atx/minilocker/README.md

# minilocker
Mini PCIe board with an accelerometer, gyroscope and magnetometer. Designed to protect againts the "Silk Road attack"
