atx/minilocker/pcb/pcb.kicad_pcb

## KiCad design pcb/pcb.kicad_pcb (2016-07-05)

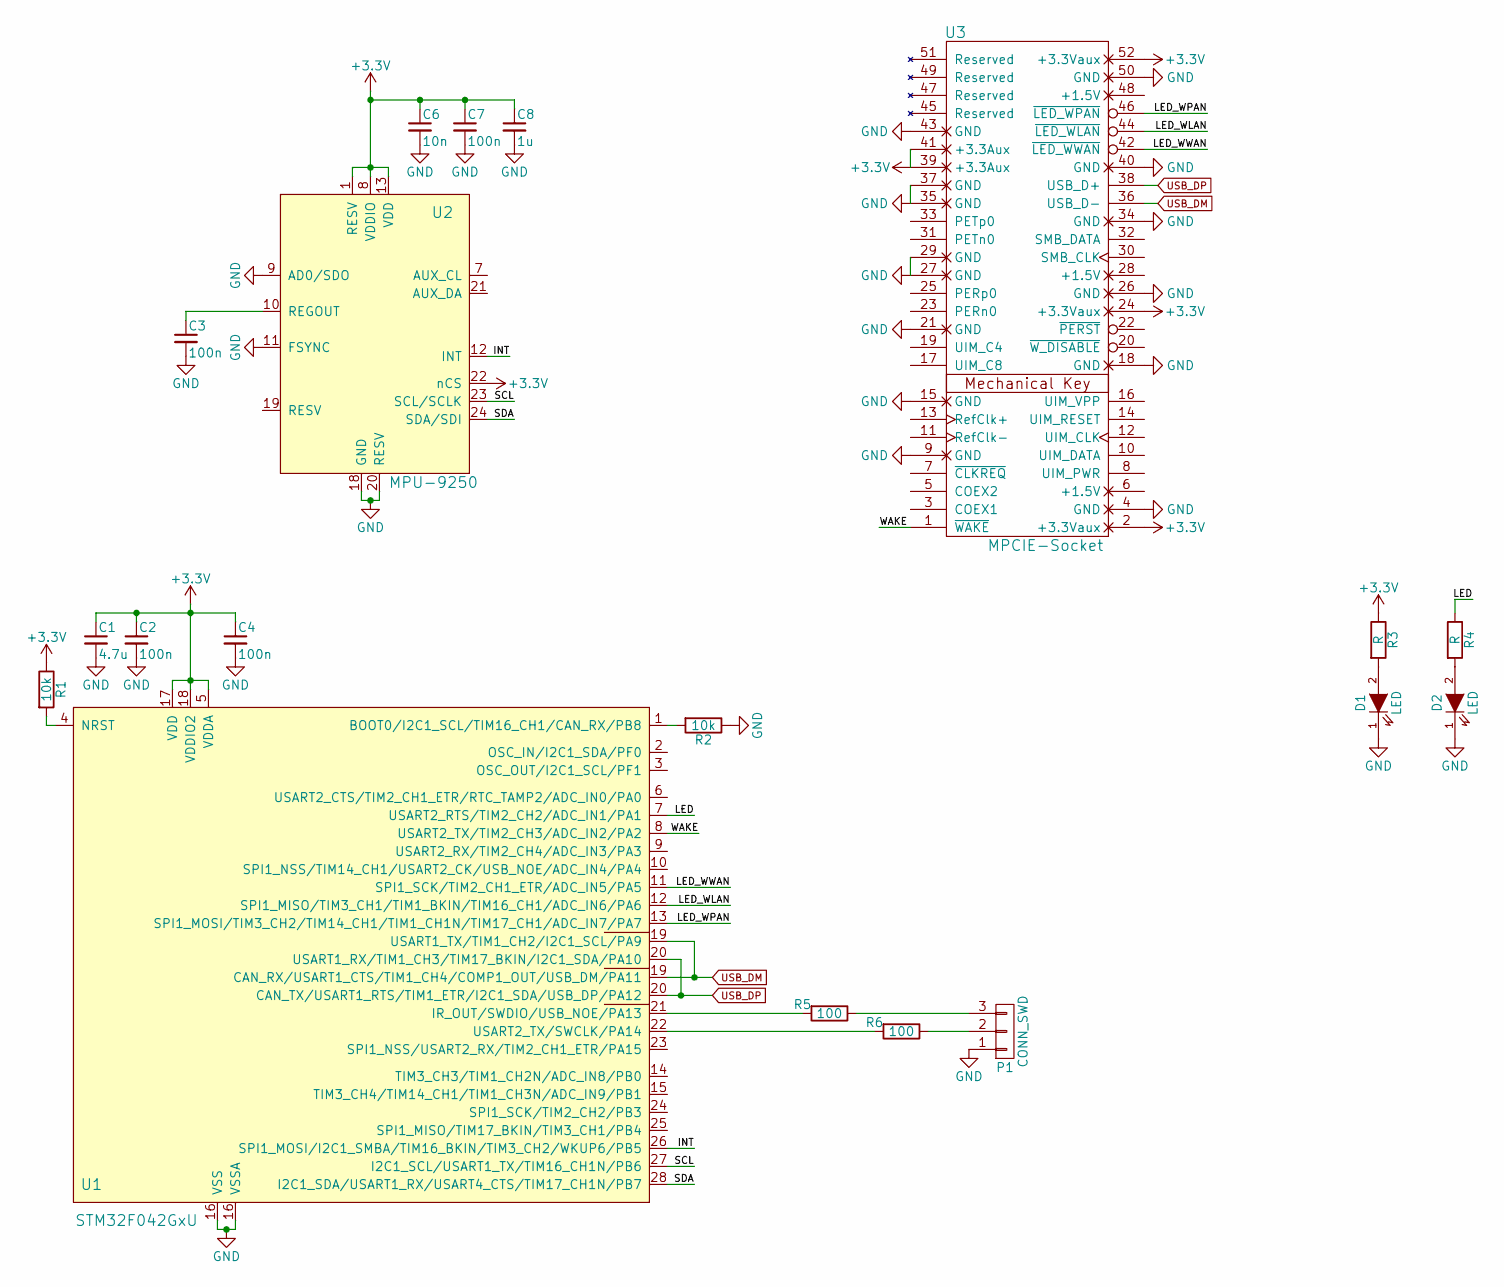
[picture p1: schematic pcb.sch]

Parts:
C1: 4.7u; R_0603
C2, C3, C4, C7: 100n; R_0402
C6: 10n; R_0402
C8: 1u; R_0402
D1, D2: LED; R_0603
P1: CONN_SWD; Pin_Header_Angled_1x03
R1, R2: 10k; R_0402
R3, R4: R; R_0402
R5, R6: 100; R_0402
U1: STM32F042GxU; UFQFPN28
U2: MPU-9250; QFN-24-1EP_3x3mm_Pitch0.4mm
U3: MPCIE-Socket; mpcie-half-card

Connections:
+3V3: C1.1, C2.1, C4.1, C6.1, C7.1, C8.1, R1.1, R3.1, U1.5 (VDDA), U1.17 (VDD), U1.18 (VDDIO2), U2.1 (RESV), U2.8 (VDDIO), U2.13 (VDD), U2.22 (nCS), U3.2 (+3.3Vaux), U3.24 (+3.3Vaux), U3.39 (+3.3Aux), U3.41 (+3.3Aux), U3.52 (+3.3Vaux)
/INT: U1.26 (SPI1_MOSI/I2C1_SMBA/TIM16_BKIN/TIM3_CH2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), U2.12 (INT)
/LED: R4.1, U1.7 (USART2_RTS/TIM2_CH2/ADC_IN1/PA1)
/LED_WLAN: U1.12 (SPI1_MISO/TIM3_CH1/TIM1_BKIN/TIM16_CH1/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), U3.44 (~LED_WLAN)
/LED_WPAN: U1.13 (SPI1_MOSI/TIM3_CH2/TIM14_CH1/TIM1_CH1N/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), U3.46 (~LED_WPAN)
/LED_WWAN: U1.11 (SPI1_SCK/TIM2_CH1_ETR/ADC_IN5/PA5), U3.42 (~LED_WWAN)
/SCL: U1.27 (I2C1_SCL/USART1_TX/TIM16_CH1N/PB6), U2.23 (SCL/SCLK)
/SDA: U1.28 (I2C1_SDA/USART1_RX/USART4_CTS/TIM17_CH1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), U2.24 (SDA/SDI)
/WAKE: U1.8 (USART2_TX/TIM2_CH3/ADC_IN2/PA2), U3.1 (~WAKE)
GND: C1.2, C2.2, C3.2, C4.2, C6.2, C7.2, C8.2, D1.1 (K), D2.1 (K), P1.1, R2.1, U1.16 (VSS), U2.9 (AD0/SDO), U2.11 (FSYNC), U2.18 (GND), U2.20 (RESV), U3.4 (GND), U3.9 (GND), U3.15 (GND), U3.18 (GND), U3.21 (GND), U3.26 (GND), U3.27 (GND), U3.29 (GND), U3.34 (GND), U3.35 (GND), U3.37 (GND), U3.40 (GND), U3.43 (GND), U3.50 (GND)
unnamed: C3.1, U2.10 (REGOUT)
unnamed: D1.2 (A), R3.2
unnamed: D2.2 (A), R4.2
unnamed: P1.2, R6.1
unnamed: P1.3, R5.1
unnamed: R1.2, U1.4 (NRST)
unnamed: R2.2, U1.1 (BOOT0/I2C1_SCL/TIM16_CH1/CAN_RX/PB8)
unnamed: R5.2, U1.21 (IR_OUT/SWDIO/USB_NOE/PA13)
unnamed: R6.2, U1.22 (USART2_TX/SWCLK/PA14)
USB_DM: U1.19 (CAN_RX/USART1_CTS/TIM1_CH4/COMP1_OUT/US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), U3.36 (USB_D-)
USB_DP: U1.20 (CAN_TX/USART1_RTS/TIM1_ETR/I2C1_SDA/USB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), U3.38 (USB_D+)

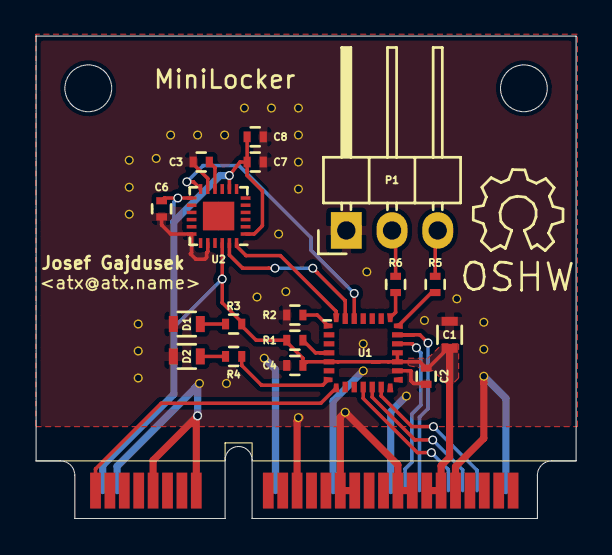
[picture p2: board pcb.kicad_pcb from above]

Board: 2 copper layers, 30.0 x 26.8 mm, 19 parts (0 on the bottom side), 21 nets.
