atx/minilocker/src/comm.c

/* 
 * Copyright (C) 2016 Institute of Applied and Experimental Physics (http://www.utef.cvut.cz/)
 *
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
 * You should have received a copy of the GNU Lesser General Public License
 * along with this program.  If not, see <http://www.gnu.org/licenses/>.*
 */

#include <limits.h>
#include <stdbool.h>
#include <stddef.h>
#include <stdint.h>
#include <string.h>

#include "acq.h"
#include "cdc.h"
#include "comm.h"
#include "utils.h"

#define FIRMWARE_VERSION	1

enum packet_type {
	/* Host -> Device */
	PACKET_NOP		= 0x01,
	PACKET_PING		= 0x02,
	PACKET_GET		= 0x03,
	PACKET_SET		= 0x04,
	PACKET_START	= 0x05,
	PACKET_STOP		= 0x06,

	/* Device -> Host */
	PACKET_PONG		= 0x82,
	PACKET_GETRESP	= 0x83,
	PACKET_IMU		= 0x84,
	PACKET_MAGNET	= 0x85,
	PACKET_ERROR    = 0xff,
};

enum error {
	EUNKNOWN	= 1,
	EINKEY		= 2,
	EINOP		= 3,
};

uint32_t comm_missed = 0;

static inline void comm_send(char *buf, size_t len, bool flush)
{
	if (!cdc_send(buf, len))
		comm_missed++;
	else if (flush)
		cdc_flush();
}

static inline void comm_send_error(enum error errno)
{
	char p[] = { PACKET_ERROR, errno };
	comm_send(p, sizeof(p), true);
}

void comm_send_imu(int16_t ax, int16_t ay, int16_t az, int16_t gx, int16_t gy, int16_t gz)
{
	char p[] = { PACKET_IMU,
				 LOBYTE(ax), HIBYTE(ax),
				 LOBYTE(ay), HIBYTE(ay),
				 LOBYTE(az), HIBYTE(az),
				 LOBYTE(gx), HIBYTE(gx),
				 LOBYTE(gy), HIBYTE(gy),
				 LOBYTE(gz), HIBYTE(gz)};
	comm_send(p, sizeof(p), false);
}

void comm_send_magnetometer(int16_t x, int16_t y, int16_t z)
{
	char p[] = { PACKET_MAGNET,
				 LOBYTE(x), HIBYTE(x),
				 LOBYTE(y), HIBYTE(y),
				 LOBYTE(z), HIBYTE(z)};
	comm_send(p, sizeof(p), false);
}

/* Handlers return the amount of bytes taken or negative value in case of failure
 * */
static int comm_cb_nop(char *buf, int len)
{
	(void)buf;
	(void)len;
	/* We do nothing, surprise! */
	return 1;
}

static int comm_cb_ping(char *buf, int len)
{
	(void)buf;
	(void)len;
	char p[] = { PACKET_PONG };
	comm_send(p, sizeof(p), true);
	return 1;
}

enum propkey {
	CONF_FW		= 0x01,
	CONF_SERNO	= 0x02,
	CONF_MAGCALX	= 0x03,
	CONF_MAGCALY	= 0x04,
	CONF_MAGCALZ	= 0x05,
};

struct propvar {
	enum propkey key;
	void (*get)(const struct propvar *prop);
	void (*set)(const struct propvar *prop, char *buf, int len);
	int len;
	void *data;
};

static void comm_const_uint16_get(const struct propvar *prop)
{
	uint16_t data = ((uint32_t) prop->data) & 0xffff;
	char p[] =
		{ PACKET_GETRESP, prop->key, LOBYTE(data), HIBYTE(data)};
	comm_send(p, sizeof(p), true);
}

static void comm_uint8_get(const struct propvar *prop)
{
	uint8_t *i = prop->data;
	char p[] =
		{ PACKET_GETRESP, prop->key, *i };
	comm_send(p, sizeof(p), true);
}

//struct boolprop {
//	void (*enable)();
//	void (*disable)();
//	bool (*isenabled)();
//};
//
//static void comm_boolprop_get(const struct propvar *prop)
//{
//	struct boolprop *bl = prop->data;
//	char p[] =
//		{ PACKET_GETRESP, prop->key,
//			bl->isenabled() ? 0x01 : 0x00 };
//
//	comm_send(p, sizeof(p), true);
//}
//
//static void comm_boolprop_set(const struct propvar *prop, char *buf, int len)
//{
//	UNUSED(prop);
//	UNUSED(len);
//
//	struct boolprop *bl = prop->data;
//
//	if (buf[2] & 0x01)
//		bl->enable();
//	else
//		bl->disable();
//}

static const struct propvar propvars[] = {
	{ CONF_FW, comm_const_uint16_get, NULL, 2, (void *)FIRMWARE_VERSION },
	{ CONF_SERNO, comm_const_uint16_get, NULL, 2, (void *)SERNO },
	{ CONF_MAGCALX, comm_uint8_get, NULL, 2, &acq_ak8963.cal_x },
	{ CONF_MAGCALY, comm_uint8_get, NULL, 2, &acq_ak8963.cal_y },
	{ CONF_MAGCALZ, comm_uint8_get, NULL, 2, &acq_ak8963.cal_z },
};

static const struct propvar *comm_resolve_key(enum propkey k)
{
	unsigned int i;

	for (i = 0; i < ARRAY_SIZE(propvars); i++)
		if (propvars[i].key == k)
			return &propvars[i];

	return NULL;
}

static int comm_cb_get(char *buf, int len)
{
	const struct propvar *p;

	if (len < 2)
		return 0;

	p = comm_resolve_key(buf[1]);

	if (p == NULL)
		comm_send_error(EINKEY);
	else if (p->get == NULL)
		comm_send_error(EINOP);
	else
		p->get(p);

	return 2;
}

static int comm_cb_set(char *buf, int len)
{
	const struct propvar *p;

	if (len < 2)
		return 0;

	p = comm_resolve_key(buf[1]);

	if (p == NULL)
		comm_send_error(EINKEY);
	else if (p->set == NULL)
		// TODO: Note that this will probably produce some garbage bytes
		comm_send_error(EINOP);
	else if (len - 2 < p->len)
		return 0;
	else
		p->set(p, buf, len);

	return 2 + p->len;
}

struct callback {
	int (*fn)(char *buf, int len);
	enum packet_type type;
};

static int comm_cb_start(char *buf, int len)
{
	UNUSED(buf);
	UNUSED(len);
	acq_start();
	return 1;
}

static int comm_cb_stop(char *buf, int len)
{
	UNUSED(buf);
	UNUSED(len);
	acq_stop();
	return 1;
}

static const struct callback callbacks[] = {
	{ comm_cb_nop,	PACKET_NOP },
	{ comm_cb_ping,	PACKET_PING },
	{ comm_cb_get,  PACKET_GET },
	{ comm_cb_set,	PACKET_SET },
	{ comm_cb_start,PACKET_START },
	{ comm_cb_stop,	PACKET_STOP },
};

void comm_push_rx(char *new, int len)
{
	static char buff[64];
	static size_t buff_len = 0;
	bool matched;
	int copied = 0;
	unsigned int i;
	int ret;

	do {
		if (copied < len && buff_len < sizeof(buff)) {
			i = min((unsigned int)len - copied, sizeof(buff) - buff_len);
			memcpy(&buff[buff_len], &new[copied], i);
			copied += i;
			buff_len += i;
		}
		matched = false;
		for (i = 0; i < ARRAY_SIZE(callbacks); i++)
			if (buff[0] == callbacks[i].type) {
				matched = true;
				ret = callbacks[i].fn(buff, buff_len);
				break;
			}
		if (!matched) {
			/* Garbage byte, should not happen */
			ret = 1;
		}
		if (ret) {
			buff_len -= ret;
			memmove(buff, &buff[ret], buff_len);
		}
		if (ret == 0 && buff_len == sizeof(buff)) {
			/* This should never happen, increase size of buff if it does */
			buff_len = 0;
		}
	} while (buff_len > 0 && ret != 0);
}
