atx/minilocker/(commit log)

2016-07-05 pcb: Add
    [pcb.kicad_pcb, pcb.sch]
2016-07-07 Add Magnetometer configuration values.
    Also rescales the .next_magnet() output to 0.0-1.0
2016-07-08 minilocker-dump: Allow selecting which sensor gets printed
    grep was just not good enought due to weird line buffering issues
2016-07-08 src: Fix device sending accelerometer data instead of gyroscope data
    [mpu.c]
2016-07-08 py: Rescale accelerometer/gyroscope output to 0.0-1.0
2016-07-08 py: Add some crude filters
2016-07-09 py: Add basic magnetometer calibration + config.py
    The config.py file was supposed to go to the previous commit, but I am way too
    tired to try to fix that at this point...
    [config.py]
